alexthomazo/sata-backplane/README.md

# SATA Backplane

This backplane is used to rotate the SATA data connector to 90°
in order to help mouting hard drive into Fractal Node 804.

The hard drives have 3.5mm between them.

The [bom](/docs/bom.csv) can be found in the docs directory.

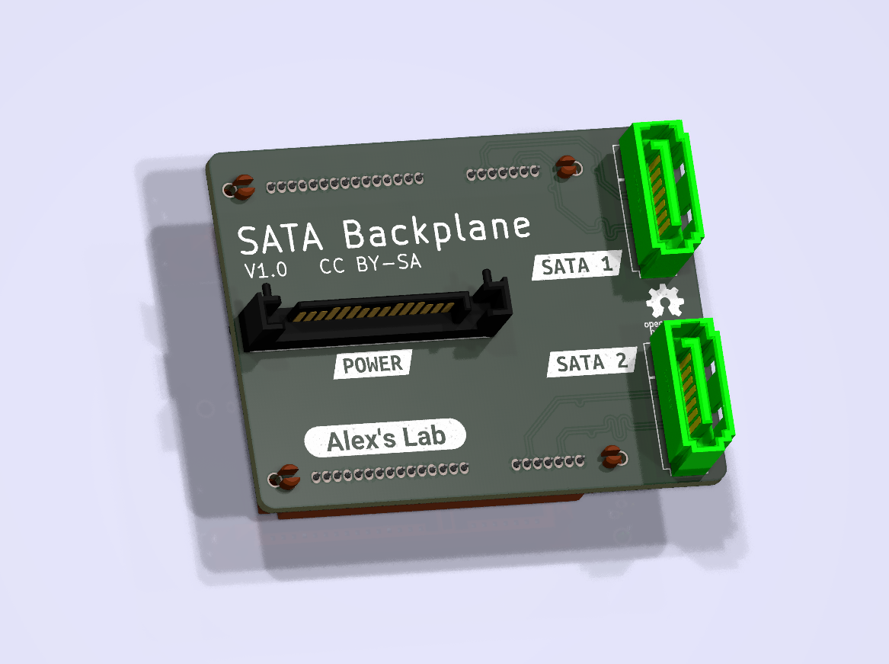
[picture p1: docs/pcb_3d.png]
PCB 3D View


## V1.0 Production

The V1.0 has been produced by JLCPCB, tested and working very well.

Here's some photos of the result:

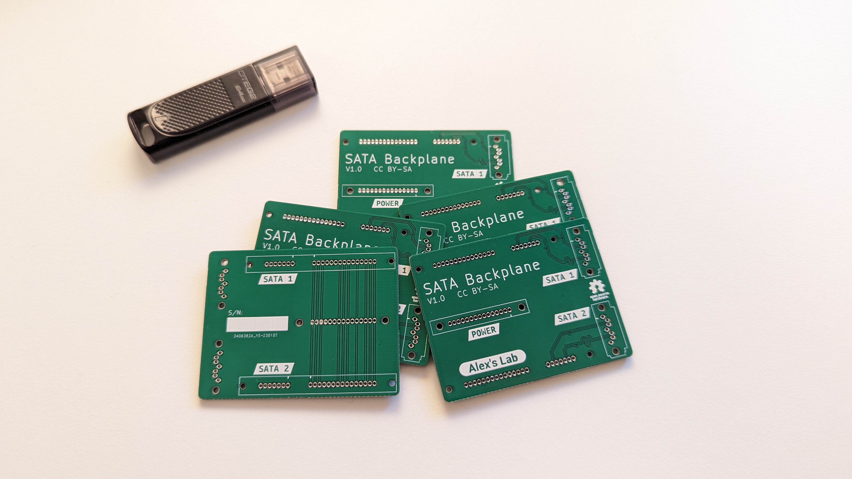
[picture p2: docs/pcbs.jpg]
PCBs


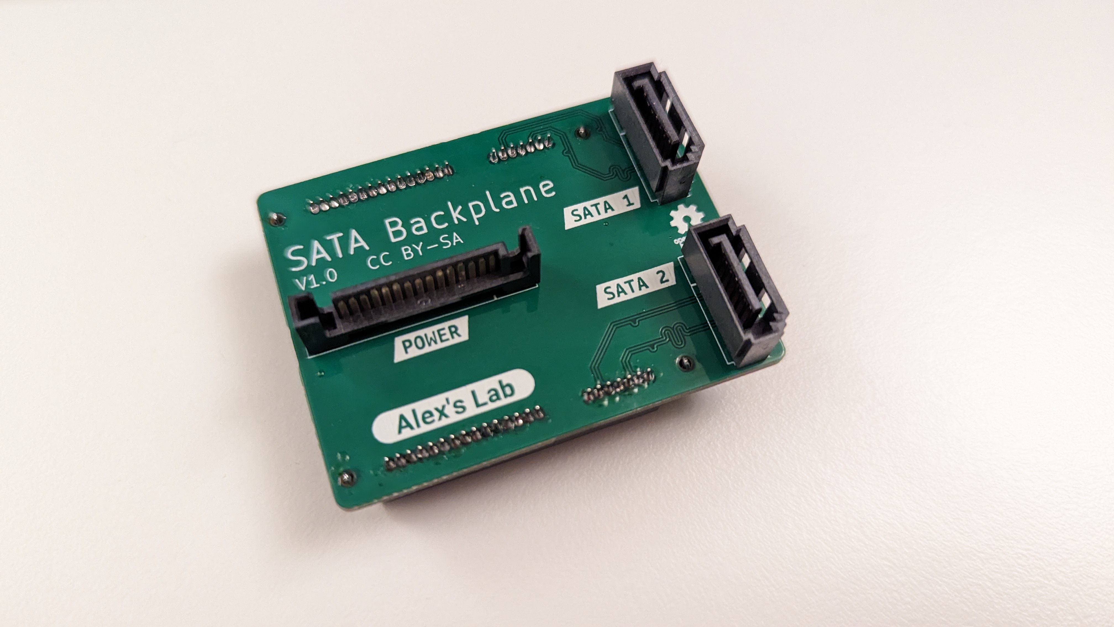
[picture p3: docs/top.jpg]
Top soldered


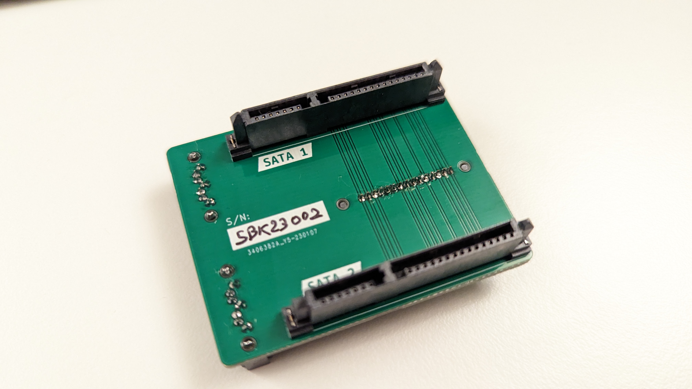
[picture p4: docs/bottom.jpg]
Bottom soldered


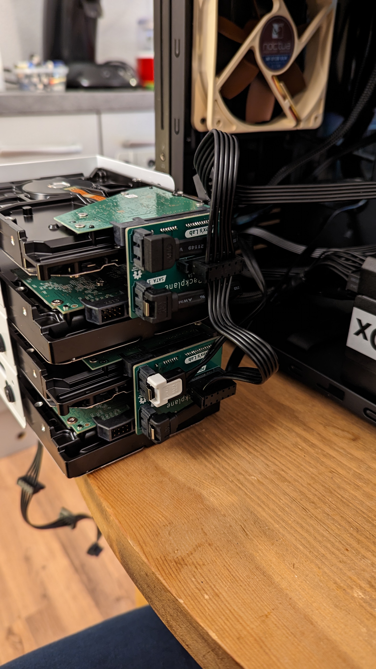
[picture p5: docs/hdd_back.jpg]
Installed on HDD


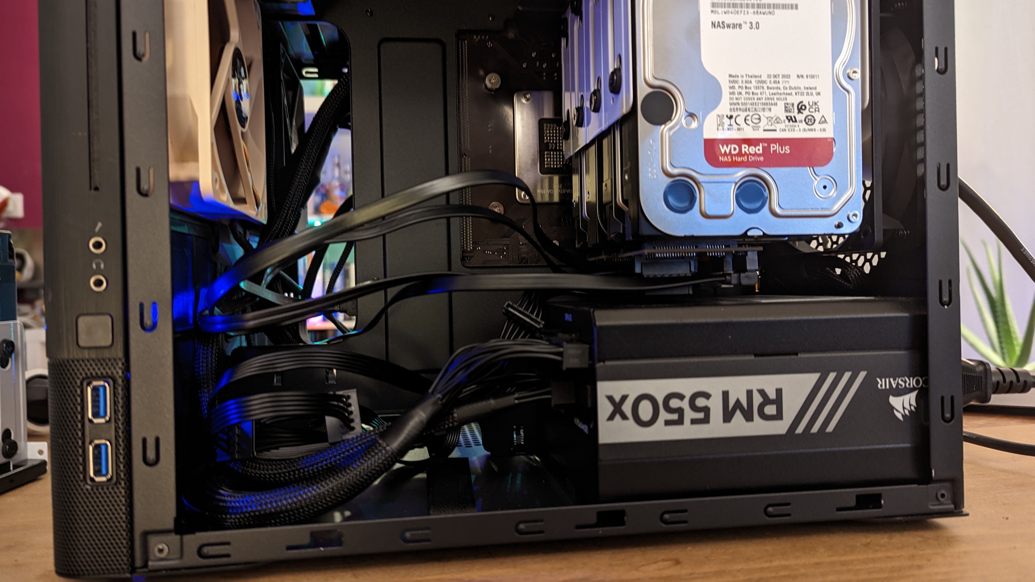
[picture p6: docs/case.jpg]
In the case


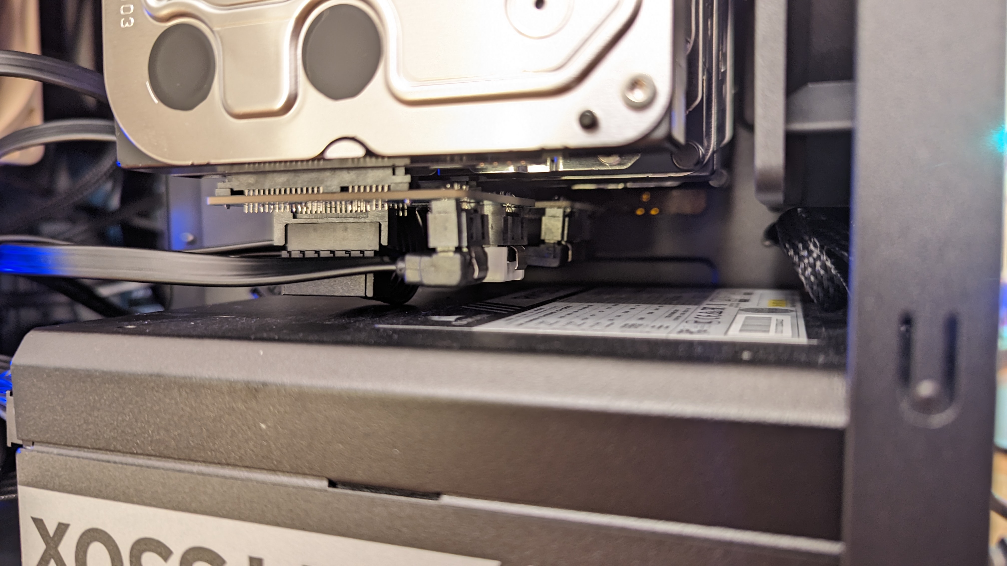
[picture p7: docs/close_mounted.jpg]
Case closeup
