alexthomazo/sata-backplane/docs/bom.csv

Product | Qty/unit | Link
Power connector | 1 | https://www.aliexpress.com/item/32767040104.html
DATA connector | 2 | https://www.aliexpress.com/item/32766673009.html
SATA connector | 2 | https://www.aliexpress.com/item/32510131428.html
