alexthomazo/sata-backplane/sata-backplane.kicad_pcb

## KiCad design sata-backplane.kicad_pcb (2023-04-26)

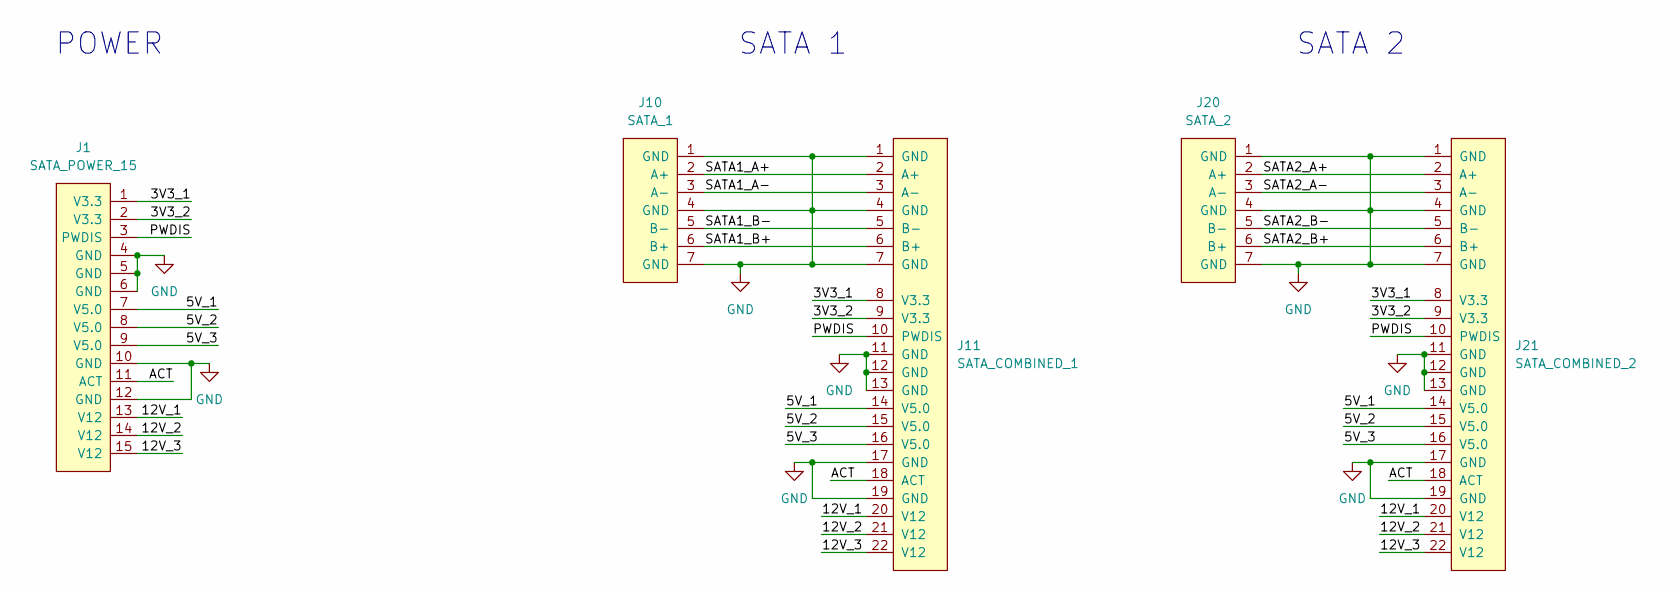
[picture p8: schematic sata-backplane.kicad_sch, SATA Backplane]

Parts:
J1: SATA_POWER_15; SATA_Power
J10: SATA_1; SATA_Data
J11: SATA_COMBINED_1; SATA_Combined
J20: SATA_2; SATA_Data
J21: SATA_COMBINED_2; SATA_Combined

Connections:
/3V3_1: J1.1 (V3.3), J11.8 (V3.3), J21.8 (V3.3)
/3V3_2: J1.2 (V3.3), J11.9 (V3.3), J21.9 (V3.3)
/5V_1: J1.7 (V5.0), J11.14 (V5.0), J21.14 (V5.0)
/5V_2: J1.8 (V5.0), J11.15 (V5.0), J21.15 (V5.0)
/5V_3: J1.9 (V5.0), J11.16 (V5.0), J21.16 (V5.0)
/12V_1: J1.13 (V12), J11.20 (V12), J21.20 (V12)
/12V_2: J1.14 (V12), J11.21 (V12), J21.21 (V12)
/12V_3: J1.15 (V12), J11.22 (V12), J21.22 (V12)
/ACT: J1.11 (ACT), J11.18 (ACT), J21.18 (ACT)
/PWDIS: J1.3 (PWDIS), J11.10 (PWDIS), J21.10 (PWDIS)
/SATA1_A+: J10.2 (A+), J11.2 (A+)
/SATA1_A-: J10.3 (A-), J11.3 (A-)
/SATA1_B+: J10.6 (B+), J11.6 (B+)
/SATA1_B-: J10.5 (B-), J11.5 (B-)
/SATA2_A+: J20.2 (A+), J21.2 (A+)
/SATA2_A-: J20.3 (A-), J21.3 (A-)
/SATA2_B+: J20.6 (B+), J21.6 (B+)
/SATA2_B-: J20.5 (B-), J21.5 (B-)
GND: J1.4 (GND), J1.5 (GND), J1.6 (GND), J1.10 (GND), J1.12 (GND), J10.1 (GND), J10.4 (GND), J10.7 (GND), J11.1 (GND), J11.4 (GND), J11.7 (GND), J11.11 (GND), J11.12 (GND), J11.13 (GND), J11.17 (GND), J11.19 (GND), J20.1 (GND), J20.4 (GND), J20.7 (GND), J21.1 (GND), J21.4 (GND), J21.7 (GND), J21.11 (GND), J21.12 (GND), J21.13 (GND), J21.17 (GND), J21.19 (GND)

Notes on the sheet:
SATA 1
SATA 2
POWER

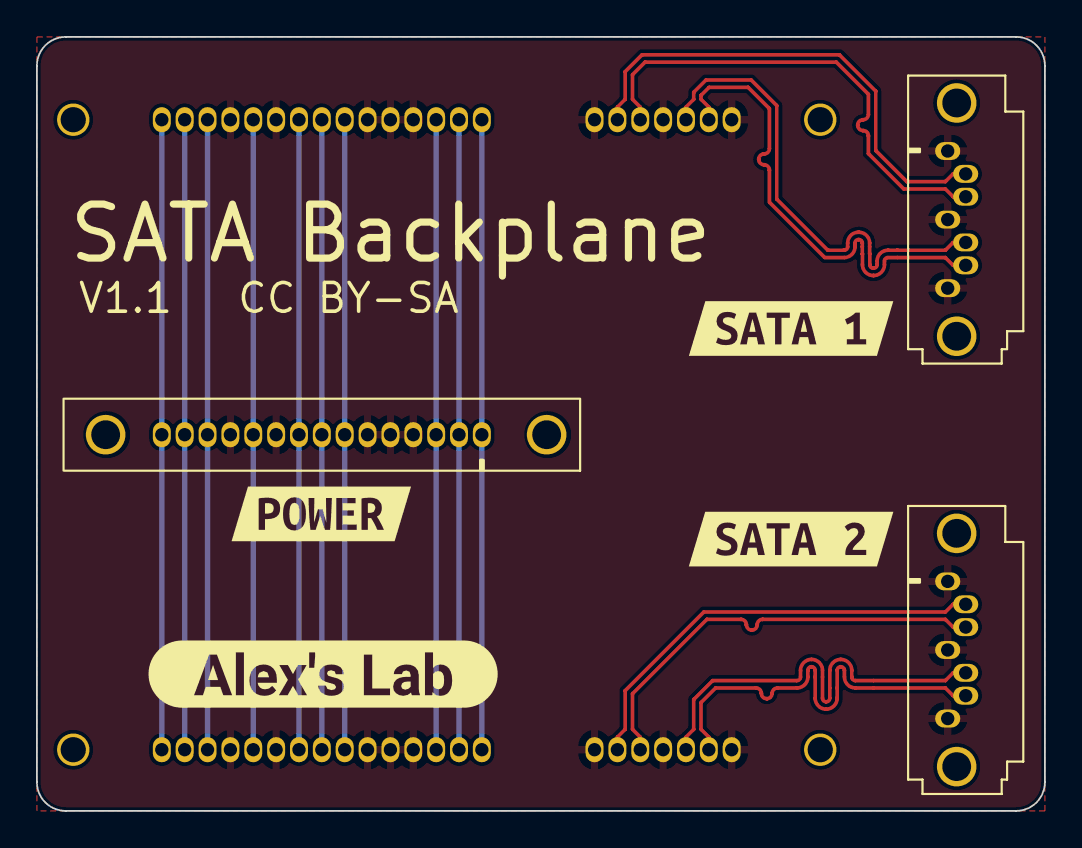
[picture p9: board sata-backplane.kicad_pcb from above]

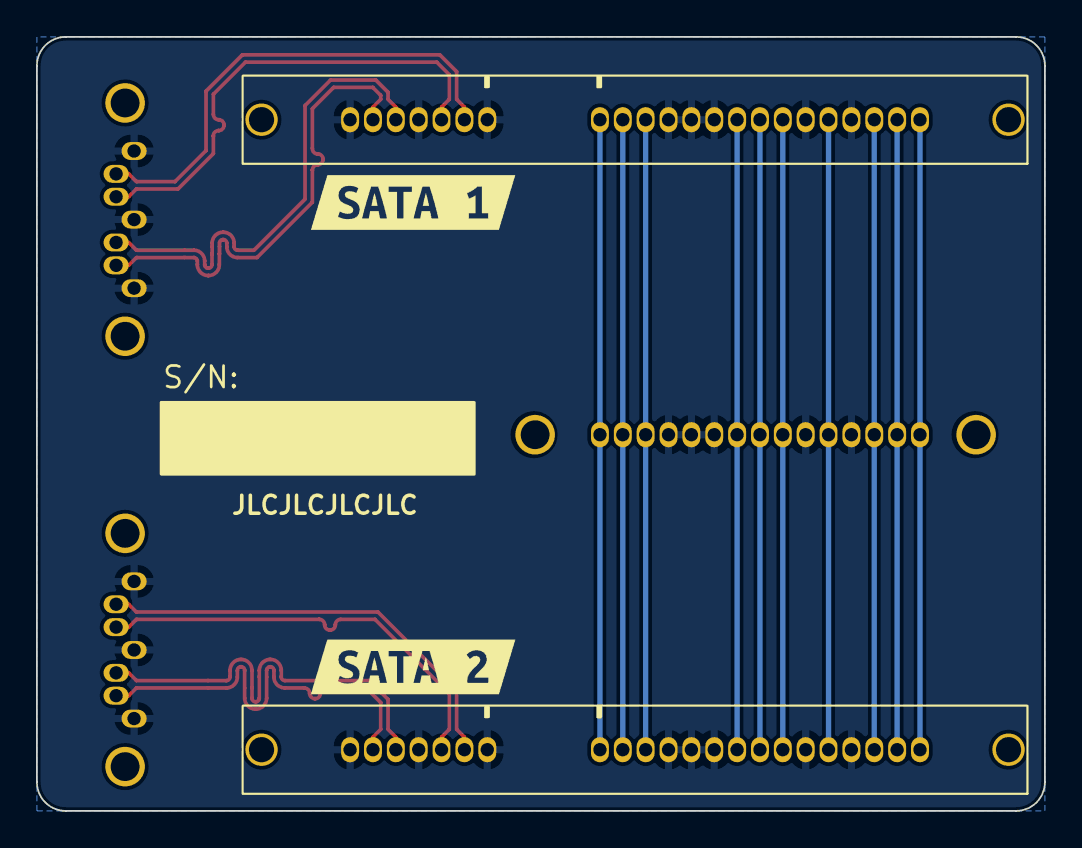
[picture p10: board sata-backplane.kicad_pcb from below]

Board: 4 copper layers, 56.0 x 43.0 mm, 11 parts (4 on the bottom side), 19 nets.

Other parts of the board:
kibuzzard-63B1B17B, kibuzzard-63B1B17B#2: G***; kibuzzard-63B1B17B
kibuzzard-63B1B127: G***; kibuzzard-63B1B127
kibuzzard-63B1B175, kibuzzard-63B1B175#2: G***; kibuzzard-63B1B175
kibuzzard-63B1B180: G***; kibuzzard-63B1B180
