alexthomazo/sata-backplane/(commit log)

2023-01-01 Initial commit with first revision
    [sata-backplane.kicad_pcb, sata-backplane.kicad_sch]
2023-01-06 Update PCB with final touch
    [sata-backplane.kicad_pcb]
2023-01-06 [docs] Add Readme and PCB 3D view
2023-04-26 Update connectors with V1.0 experience
    [sata-backplane.kicad_pcb]
2023-04-26 Update docs with V1.0 production
    [bom.csv]
