alexthomazo/sata-backplane/(notices)

Notices in the files:
sata-backplane.kicad_sch:
GPL v3
sata-backplane.kicad_pcb:
V1.1 CC BY-SA
